schmich/g9impulse/assets/starcell_full.png

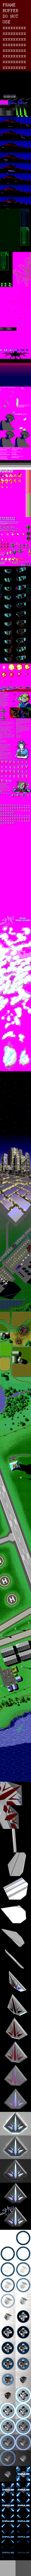
assets/starcell_full.png
