schmich/g9impulse/src/game/world.c

#include "world.h"
#include "updateable.h"
#include "projectile.h"
#include "player.h"
#include "input.h"
#include "enemy.h"
#include "awards.h"
#include "background.h"
#include "collision.h"
#include "level.h"
#include "artifact.h"
#include "health-meter.h"
#include "heat-meter.h"
#include "life-meter.h"
#include "nuke-meter.h"
#include "weapon-indicator.h"
#include "text.h"

#define SUICIDE_TIME 25

static bool suicide(void)
{
    static uint8 resetCounter = SUICIDE_TIME;
    Input* input = getInputStatus();

    if (input->buttonBPressed &&
        input->buttonAPressed &&
        input->selectPressed)
    {
        if (--resetCounter == 0)
            return true;
    }
    else
    {
        resetCounter = SUICIDE_TIME;
    }

    return false;
}

static void destroyWorld(World* w)
{
    Node* curr;

    foreach (curr, w->updateables)
        destroy(curr->data);

    foreach (curr, w->enemies)
        destroy(curr->data);

    foreach (curr, w->playerProjectiles)
        destroy(curr->data);

    foreach (curr, w->enemyProjectiles)
        destroy(curr->data);

    foreach (curr, w->overlays)
        destroy(curr->data);

    foreach (curr, w->underlays)
        destroy(curr->data);

    foreach (curr, w->artifacts)
        destroy(curr->data);

    destroy(w->updateables);
    destroy(w->enemies);
    destroy(w->playerProjectiles);
    destroy(w->enemyProjectiles);
    destroy(w->overlays);
    destroy(w->underlays);
    destroy(w->artifacts);

    destroy(w->lifeMeter);
    destroy(w->healthMeter);
    destroy(w->heatMeter);
    destroy(w->nukeMeter);
    destroy(w->weaponIndicator);

    destroy(w->awardsOverlay);

    destroy(w->player);
    destroyStatic(w->level);
}

World* createWorld(Player* player, Level* level)
{
    Point start;

    World* w = new(World);
    w->destroy = destroyWorld;

    w->updateables = createList();
    w->enemies = createList();
    w->playerProjectiles = createList();
    w->enemyProjectiles = createList();
    w->overlays = createList();
    w->underlays = createList();
    w->artifacts = createList();

    w->level = level;
    w->player = player;

    setSpriteCenterTop(player, screenCenterBottom());

    w->healthMeter = createHealthMeter(player, makePoint(130, 230));
    w->heatMeter = createHeatMeter(player, makePoint(1, 230));
    w->nukeMeter = createNukeMeter(player, makePoint(155, 3));
    w->lifeMeter = createLifeMeter(player, makePoint(154, 220));
    w->weaponIndicator = createWeaponIndicator(player, makePoint(1, 220));

    w->gameOver = false;
    w->awardsOverlay = NULL;

    w->respawnShow = true;
    w->respawning = false;
    w->respawnStep = 0;

#ifdef _DEBUG
    w->intro = false;
#else
    w->intro = true;
#endif

    w->introStep = 0;
    w->active = true;

    return w;
}

bool active(World* w)
{
    return w->active;
}

void addUpdateable(World* world, Updateable* u)
{
    appendElement(world->updateables, u);
}

void addEnemy(World* world, Enemy* e)
{
    ++world->player->stats->enemiesFaced;
    appendElement(world->enemies, e);
}

void addPlayerProjectile(World* world, Projectile* p)
{
    ++world->player->stats->shotsFired;
    appendElement(world->playerProjectiles, p);
}

void addEnemyProjectile(World* world, Projectile* p)
{
    ++world->player->stats->shotsFaced;
    appendElement(world->enemyProjectiles, p);
}

void addOverlay(World* world, Updateable* u)
{
    appendElement(world->overlays, u);
}

void addUnderlay(World* world, Updateable* u)
{
    appendElement(world->underlays, u);
}

void addArtifact(World* world, Artifact* a)
{
    ++world->player->stats->artifactsGiven;
    appendElement(world->artifacts, a);
}

Node* removeUpdateable(World* world, Node* u)
{
    destroy(u->data);
    return removeNode(world->updateables, u);
}

Node* removeEnemy(World* world, Node* e)
{
    destroy(e->data);
    return removeNode(world->enemies, e);
}

Node* removePlayerProjectile(World* world, Node* p)
{
    destroy(p->data);
    return removeNode(world->playerProjectiles, p);
}

Node* removeEnemyProjectile(World* world, Node* p)
{
    destroy(p->data);
    return removeNode(world->enemyProjectiles, p);
}

Node* removeOverlay(World* world, Node* u)
{
    destroy(u->data);
    return removeNode(world->overlays, u);
}

Node* removeUnderlay(World* world, Node* u)
{
    destroy(u->data);
    return removeNode(world->underlays, u);
}

Node* removeArtifact(World* world, Node* a)
{
    destroy(a->data);
    return removeNode(world->artifacts, a);
}

void drawWorld(World* world)
{
    uint8 i;
    Image* img;
    Node* curr;

    drawBackground(world->level->background);

    foreach (curr, world->underlays)
        drawSprite(curr->data);

    foreach (curr, world->artifacts)
        drawSprite(curr->data);

    foreach (curr, world->enemyProjectiles)
        drawSprite(curr->data);

    foreach (curr, world->enemies)
        drawSprite(curr->data);

    foreach (curr, world->playerProjectiles)
        drawSprite(curr->data);

    if (!dead(world->player) && world->respawnShow)
        drawPlayer(world->player);

    foreach (curr, world->updateables)
        drawSprite(curr->data);

    foreach (curr, world->overlays)
        drawSprite(curr->data);

    if (!world->gameOver)
    {
        drawSprite(world->heatMeter);
        drawSprite(world->healthMeter);
        drawNukeMeter(world->nukeMeter);
        drawLifeMeter(world->lifeMeter);
        drawWeaponIndicator(world->weaponIndicator);

        drawNumber(world->player->stats->score, makePoint(2, 2), COLOR_WHITE);

#ifdef _DEBUG
        drawNumber(world->level->background->progress, makePoint(2, 17), COLOR_WHITE);
        drawNumber(memoryFree(), makePoint(2, 31), COLOR_WHITE);
        drawNumber(world->player->stats->enemiesFaced, makePoint(2, 45), COLOR_WHITE);
#endif
    }
    else
    {
        drawAwardsOverlay(world->awardsOverlay);
    }
}

void updateWorld(World* world)
{
    Node* curr;
    int16 stop;

    if (world->intro)
    {
        update(world->player->engine, world); // HACK this sucks

        if (++world->introStep == 2)
        {
            stop = SCREEN_HEIGHT - (int16)spriteHeight(world->player) - 10;

            if (--world->player->position.y == stop)
                world->intro = false;

            world->introStep = 0;
        }
    }
    else
    {
        if (!dead(world->player))
            update(world->player, world);
    }

    if (world->respawning)
    {
        if (++world->respawnStep == 1)
        {
            world->respawnShow = !world->respawnShow;
            world->respawnStep = 0;

            if (++world->respawnCycles == 100)
                world->respawning = false;
        }
    }

    if (world->gameOver)
    {
        if (updateAwardsOverlay(world->awardsOverlay))
        {
            world->player->stats->score += totalBonus(world->awardsOverlay->awards);
            world->active = false;
        }
    }

    update(world->heatMeter, world);
    update(world->healthMeter, world);

    update(world->level->background, world);

    if (!world->gameOver)
        updateLevel(world->level, world);
    
    curr = world->updateables->head;
    while (curr != NULL)
    {
        if (update(curr->data, world) == UPDATE_REMOVE)
            curr = removeUpdateable(world, curr);
        else
            curr = curr->next;
    }

    curr = world->enemies->head;
    while (curr != NULL)
    {
        if (update(curr->data, world) == UPDATE_REMOVE)
            curr = removeEnemy(world, curr);
        else
            curr = curr->next;
    }

    curr = world->playerProjectiles->head;
    while (curr != NULL)
    {
        if (update(curr->data, world) == UPDATE_REMOVE)
            curr = removePlayerProjectile(world, curr);
        else
            curr = curr->next;
    }

    curr = world->enemyProjectiles->head;
    while (curr != NULL)
    {
        if (update(curr->data, world) == UPDATE_REMOVE)
            curr = removeEnemyProjectile(world, curr);
        else
            curr = curr->next;
    }

    curr = world->artifacts->head;
    while (curr != NULL)
    {
        if (update(curr->data, world) == UPDATE_REMOVE)
            curr = removeArtifact(world, curr);
        else
            curr = curr->next;
    }

    curr = world->overlays->head;
    while (curr != NULL)
    {
        if (update(curr->data, world) == UPDATE_REMOVE)
            curr = removeOverlay(world, curr);
        else
            curr = curr->next;
    }

    curr = world->underlays->head;
    while (curr != NULL)
    {
        if (update(curr->data, world) == UPDATE_REMOVE)
            curr = removeUnderlay(world, curr);
        else
            curr = curr->next;
    }
    
    if (!world->gameOver)
    {
        if (suicide())
        {
            kill(world->player, world);
        }

        if (dead(world->player))
        {
            if (empty(world->updateables))
            {
                if (world->player->lives == 0)
                {
                    world->gameOver = true;
                    world->awardsOverlay = createAwardsOverlay(world->player);
                }
                else
                {
                    respawnPlayer(world->player);

                    world->respawning = true;
                    world->respawnStep = 0;
                    world->respawnCycles = 0;
                    world->respawnShow = true;

                    world->intro = true;
                    world->introStep = 0;
                }
            }
        }
    }
}

void collideWorld(World* world)
{
    Node* proj;
    Node* enemy;
    Node* artifact;
    bool killed;
    
    //
    // collide enemies with player's projectiles
    //
    enemy = world->enemies->head;
    while (enemy != NULL)
    {
        killed = false;

        proj = collides(enemy->data, world->playerProjectiles);
        if (proj != NULL)
        {
            ++world->player->stats->shotsLanded;

            impact(proj->data, enemy->data, world);
            if (damage(enemy->data, ((Projectile*)proj->data)->damage))
            {
                killed = true;
                kill(enemy->data, world);
            }

            if (!((Projectile*)proj->data)->invincible)
                removePlayerProjectile(world, proj);
        }

        if (killed)
        {
            enemyKilled(world->player, enemy->data, false);
            enemy = removeEnemy(world, enemy);
        }
        else
            enemy = enemy->next;
    }

    if (!dead(world->player))
    {
        //
        // collide player with enemies' projectiles
        //
        proj = collides(world->player, world->enemyProjectiles);
        if (proj != NULL)
        {
            impact(proj->data, world->player, world);

#ifndef _DEBUG
            if (!world->respawning && damagePlayer(world->player, ((Projectile*)proj->data)->damage))
                kill(world->player, world);
#endif

            if (!((Projectile*)proj->data)->invincible)
                removeEnemyProjectile(world, proj);
        }

        //
        // collide player with artifacts
        //
        artifact = collides(world->player, world->artifacts);
        if (artifact != NULL)
        {
            affect(artifact->data, world->player, world);
            removeArtifact(world, artifact);
        }

        //
        // collide player with enemies themselves
        //
        enemy = collides(world->player, world->enemies);
        if (enemy != NULL)
        {
            if (!((Enemy*)enemy->data)->ground)
            {
#ifndef _DEBUG
                if (!world->respawning && damagePlayer(world->player, 2))
                    kill(world->player, world);
#endif

                enemyKilled(world->player, enemy->data, true);
                ++world->player->stats->kamikazes;

                if (damage(enemy->data, 50))
                {
                    kill(enemy->data, world);
                    removeEnemy(world, enemy);
                }
            }
        }
    }
}
