schmich/g9impulse/src/game/high-score.c

#include "text.h"
#include "input.h"
#include "storage.h"
#include "list.h"
#include "gpu.h"
#include "delay.h"
#include "background.h"
#include "score.anim.inl"
#include "high-score.h"

#define LOCATION_HIGH_SCORES 0
#define LOCATION_LAST_INITS  (LOCATION_HIGH_SCORES + (3 + 2) * 10)
#define LOCATION_MAGIC       1020

typedef struct ScoreEntry
{
    char   initials[4];
    uint16 score;
} ScoreEntry;

static void destroyScores(List* scores)
{
    Node* curr;

    foreach (curr, scores)
        free(curr->data);

    destroy(scores);
}

static bool validInitials(char* initials)
{
    char* c;
    for (c = initials; *c != NULL; ++c)
    {
        if (*c >= 'A' && *c <= 'Z')
            return true;

        if (*c >= '0' && *c <= '9')
            return true;

        if (*c == ' ')
            return true;
    }

    return false;
}

static bool validMagic(void)
{
    char magic[4];
    readStorage(magic, 4, LOCATION_MAGIC);

    return magic[0] == 0xDE
        && magic[1] == 0xAD
        && magic[2] == 0xBE
        && magic[3] == 0xEF;
}

static void saveHighScores(List* highScores)
{
    uint8 pos = LOCATION_HIGH_SCORES;

    Node* curr;
    ScoreEntry* entry;

    foreach (curr, highScores)
    {
        entry = (ScoreEntry*)curr->data;

        writeStorage(entry->initials, 3, pos);
        writeStorage((char*)&entry->score, 2, pos + 3);
        
        pos += 5;
    }
}

static List* loadHighScores(void)
{
    uint8 i;
    uint8 pos;
    List* scores = createList();
    ScoreEntry* entry;

    for (i = 0, pos = LOCATION_HIGH_SCORES; i < 10; ++i, pos += 5)
    {
        entry = new(ScoreEntry); 

        readStorage(entry->initials, 3, pos);
        entry->initials[3] = '\0';

        readStorage((char*)&entry->score, 2, pos + 3);

        appendElement(scores, entry);
    }

    return scores;
}

static bool displayHighScores(List* highScores, Node* scorePos)
{
    uint8 y;

    uint8 buffer;
    Animation* logo = logoAnimation();
    Animation* highScore = highScoreAnimation();

    char _[] = "_";
    uint8 pos = 0;
    char* initial;

    uint8 color;
    Node* curr;
    ScoreEntry* entry;
    Input* event = getInputEvent();

    //
    // HACK background repeat position hardcoded
    //
    Background* background = createBackground(6824);

    uint16 delay = 0;

    setDoubleBuffer(true);
    clearBuffers();
    while (!event->startPressed)
    {
        delay_ms(10);

        event = getInputEvent();
        if (scorePos != NULL)
        {
            initial = ((ScoreEntry*)scorePos->data)->initials + pos;

            if (event->buttonBPressed)
            {
                if (pos == 0)
                    pos = 2;
                else
                    --pos;
            }
            else if (event->buttonAPressed)
            {
                if (++pos > 2)
                    pos = 0;
            }
            else if (event->leftPressed)
            {
                if (*initial == 'A')
                    *initial = ' ';
                else if (*initial == ' ')
                    *initial = 'Z';
                else
                    --*initial;
            }
            else if (event->rightPressed)
            {
                if (*initial == 'Z')
                    *initial = ' ';
                else if (*initial == ' ')
                    *initial = 'A';
                else
                    ++*initial;
            }
        }
        else
        {
            delay += 10;
            if (delay >= 15000)
                return true;
        }

        drawBackground(background);
        drawImage(&logo->images[0], makePoint(0, 0), true);

        if (scorePos != NULL)
            drawImage(&highScore->images[0], makePoint(78, 15), true);

        update(background, NULL);

        y = 70;
        foreach (curr, highScores)
        {
            if (scorePos != curr)
                color = COLOR_WHITE;
            else
            {
                color = COLOR_BLUE;
                drawText(_, makePoint(85 + pos * textWidth(_), y - 1), COLOR_BLUE);
            }

            entry = (ScoreEntry*)curr->data;
            drawText(entry->initials, makePoint(85, y), color);
            drawNumber(entry->score, makePoint(115, y), color);

            y += 16;
        }

        flipBuffer(&buffer);
    }

    destroy(background);

    return false;
}

static void setDefaultHighScores(void)
{
    char magic[] = { 0xDE, 0xAD, 0xBE, 0xEF };
    char inits[] = "CPS_LH _ZC _JPC_EMS_SYB_ECE_ABC_XYZ_DEF";

    uint16 scores[] = {100, 99, 98, 97, 96,
                       95,  94, 93, 92, 91};

    uint8 i;
    char* currInit;
    List* highScores = createList();
    ScoreEntry* entry;

    for (i = 0; i < 10; ++i)
    {
        entry = new(ScoreEntry);

        entry->initials[0] = inits[i * 4];
        entry->initials[1] = inits[i * 4 + 1];
        entry->initials[2] = inits[i * 4 + 2];
        entry->initials[3] = '\0';
        entry->score = scores[i];

        appendElement(highScores, entry);
    }

    saveHighScores(highScores);
    writeStorage(inits, 3, LOCATION_LAST_INITS);
    writeStorage(magic, 4, LOCATION_MAGIC);

    destroyScores(highScores);
}

static Node* highScorePosition(uint16 score, List* highScores)
{
    Node* curr;
    ScoreEntry* entry;

    foreach (curr, highScores)
    {
        entry = (ScoreEntry*)curr->data;

        if (score > entry->score)
            return curr;
    }

    return NULL;
}

bool showHighScores()
{
    List* highScores;
    bool  startPressed;

    if (!validMagic())
        setDefaultHighScores();

    highScores = loadHighScores();
    startPressed = displayHighScores(highScores, NULL);

    destroyScores(highScores);
    return startPressed;
}

void checkHighScore(uint16 score)
{
    char initials[3];
    List* highScores;
    Node* scorePos;
    Node* newScore;
    ScoreEntry* entry;

    if (!validMagic())
        setDefaultHighScores();

    highScores = loadHighScores();

    scorePos = highScorePosition(score, highScores);
    if (scorePos != NULL)
    {
        entry = new(ScoreEntry);
        entry->score = score;

        readStorage(entry->initials, 3, LOCATION_LAST_INITS);
        entry->initials[3] = '\0';

        if (!validInitials(entry->initials))
        {
            //
            // somehow we got into an inconsistent state with the
            // last initials entered, so just reset them
            //
            entry->initials[0] = entry->initials[1] = entry->initials[2] = 'A';
        }

        newScore = insertElement(highScores, scorePos, entry);
        removeNode(highScores, highScores->tail);

        displayHighScores(highScores, newScore);
        saveHighScores(highScores);

        writeStorage(entry->initials, 3, LOCATION_LAST_INITS);
    }

    destroyScores(highScores);
}
