schmich/g9impulse/src/game/enemy.c

#include "enemy.h"

static void destroyEnemy(Enemy* e)
{
    destroy(e->behavior);
}

static void fireEnemy(Entity* e, World* w)
{
    e->spawnProjectile(e, w, spriteCenterBottom(e));
}

Enemy* createEnemy(Animation* anim,
                   uint8 initFrame, 
                   Behavior* behavior,
                   uint16 health,
                   Point where,
                   SpawnFn onProjectileSpawn,
                   KillFn onKill)
{
    Enemy* e = new(Enemy);
    e->destroy = destroyEnemy;
    e->behavior = behavior;
    e->position = where;
    e->health = e->maxHealth = health;
    e->kill = onKill;
    e->fire = fireEnemy;
    e->animation = anim;
    e->currentFrame = initFrame;
    e->spawnProjectile = onProjectileSpawn;
    e->ground = false;

    return e;
}
