schmich/g9impulse/src/game/entity.c

#include "entity.h"

void kill(Entity* who, World* world)
{
    damage(who, who->health);
    who->kill(who, world);
}

bool damage(Entity* who, uint16 damage)
{
    if (damage >= who->health)
    {
        who->health = 0;
        return true;
    }
    else
    {
        who->health -= damage;
        return false;
    }
}

bool dead(Entity* who)
{
    return who->health == 0;
}

void fire(Entity* e, World* w)
{
    e->fire(e, w);
}

void nullFire(Entity* e, World* w)
{
    // do nothing!
}

void nullProjectileSpawn(Entity* e, World* w, Projectile** p)
{
    *p = NULL;
}
