schmich/g9impulse/src/game/world.h

#ifndef WORLD_H
#define WORLD_H

#include "common.h"
#include "destroyable.h"
#include "list.h"

typedef struct Player Player;
typedef struct Background Background;
typedef struct Updateable Updateable;
typedef struct Projectile Projectile;
typedef struct Artifact Artifact;
typedef struct Enemy Enemy;
typedef struct Level Level;
typedef struct HealthMeter HealthMeter;
typedef struct HeatMeter HeatMeter;
typedef struct NukeMeter NukeMeter;
typedef struct LifeMeter LifeMeter;
typedef struct WeaponIndicator WeaponIndicator;
typedef struct AwardsOverlay AwardsOverlay;

typedef struct World
{
    DESTROYABLE_BASE;

    bool    active;

    List*   updateables;
    List*   enemies;
    List*   playerProjectiles;
    List*   enemyProjectiles;
    List*   overlays;
    List*   underlays;
    List*   artifacts;

    Player* player;
    Level*  level;

    HealthMeter*        healthMeter;
    HeatMeter*          heatMeter;
    NukeMeter*          nukeMeter;
    LifeMeter*          lifeMeter;
    WeaponIndicator*    weaponIndicator;

    AwardsOverlay* awardsOverlay;

    bool    respawnShow;
    bool    respawning;
    uint8   respawnStep;
    uint8   respawnCycles;

    bool    intro;
    uint8   introStep;

    bool    gameOver;
} World;

World* createWorld(Player* player, Level* level);

bool active(World* world);

void drawWorld(World* world);
void updateWorld(World* world);
void collideWorld(World* world);

void addUpdateable(World* world, Updateable* u);
void addPlayerProjectile(World* world, Projectile* p);
void addEnemyProjectile(World* world, Projectile* p);
void addEnemy(World* world, Enemy* e);
void addOverlay(World* world, Updateable* u);
void addUnderlay(World* world, Updateable* u);
void addArtifact(World* world, Artifact* a);

Node* removeUpdateable(World* world, Node* u);
Node* removePlayerProjectile(World* world, Node* p);
Node* removeEnemyProjectile(World* world, Node* p);
Node* removeEnemy(World* world, Node* e);
Node* removeOverlay(World* world, Node* u);
Node* removeUnderlay(World* world, Node* u);
Node* removeArtifact(World* world, Node* a);

#endif // WORLD_H
