schmich/g9impulse/src/game/projectile.c

#include "projectile.h"

static void destroyProjectile(Projectile* p)
{
    destroy(p->behavior);
}

Projectile* createProjectile(Animation* anim,
                             uint8 initFrame,
                             Behavior* behavior,
                             uint8 damage,
                             Point where,
                             ImpactFn onImpact,
                             bool invincible)
{
    Projectile* p = new(Projectile);
    p->destroy = destroyProjectile;
    p->behavior = behavior;
    p->position = where;
    p->damage = damage;
    p->impact = onImpact;
    p->animation = anim;
    p->currentFrame = initFrame;
    p->invincible = invincible;

    return p;
}

void impact(Projectile* proj, Sprite* who, World* world)
{
    proj->impact(proj, who, world); 
}

void nullImpact(Projectile* proj, Sprite* who, World* world)
{
    // do nothing!
}
