schmich/g9impulse/src/game/projectile.h

#ifndef PROJECTILE_H
#define PROJECTILE_H

#include "common.h"
#include "updateable.h"

struct Projectile;
typedef near rom void (*ImpactFn)(struct Projectile*, Sprite*, World*);

#define PROJECTILE_BASE UPDATEABLE_BASE; \
                        uint8 damage; \
                        ImpactFn impact; \
                        bool invincible

typedef struct Projectile
{
    PROJECTILE_BASE;
} Projectile;

Projectile* createProjectile(Animation* anim,
                             uint8 initFrame,
                             Behavior* behavior,
                             uint8 damage,
                             Point where,
                             ImpactFn onImpact,
                             bool invincible);

void impact(Projectile* proj, Sprite* who, World* world);
void nullImpact(Projectile*, Sprite*, World*);

#endif // PROJECTILE_H
