schmich/g9impulse/(commit log)

2006-02-05 Initial checkin of StarCell project files.
    [I2C.obj, gpu_pic.obj, gpuchip_pad.csv, midi.obj, vga-timing.xls]
2006-02-05 Removed a bunch of cruft.
    [I2C.obj, gpu_pic.obj, midi.obj]
2006-02-05 cleaned up repository. added up to date art.
    [gpuchip_pad.csv]
2006-02-13 currently not working (not sure why). Committing to check out old version
    [intro.c, iomain.c, main.c]
2006-02-19 deleted old directories that we never used
    [vga-timing.xls]
2006-02-26 Added collision detection, enemy shooting, improved behaviors, levels, spawning. Added cloud and plasma entities. Integrated explosions and enemy deaths. Fixed input system.
    [animation.h, background.c, background.h, cloud.c, cloud.h, collision.c]
2006-02-27 Fixed glitching (for XSA-50) remember to propogate these changes to the XSA-100
    [gpuchip.vhd]
2006-02-27 Added medium and large explosion data, much improved Makefile, player death now resets game, added beginnings of artifacts.
    [artifact.c, artifact.h, destroyable.c, destroyable.h, explosion.c, level.h, main.c]
2006-03-03 Added fractional movements to Boring behavior (doesn't work that well), added player health sprite in screen corner.
    [cloud.c, cloud.h, intro.c]
2006-03-04 Infrastructure rework because of realization: projectiles, enemies, etc, should be completely specified at runtime, i.e. no special structures/data for any of them.
    [enemy.c, enemy.h, player.c]
2006-03-04 Temporarily broken, renamed Sprite to Figure.
    [enemy.c, figure.c, figure.h, intro.c, player.c, player.h, sprite.c]
2006-03-04 Temporarily broken, renamed Entity to Sprite.
    [cloud.c, collision.c, enemy.c, entity.c, entity.h]
2006-03-04 Fixed player/enemy shooting, moved some files to sdk/
    [enemy.c, enemy.h, entity.c, entity.h, main.c, player.c]
2006-03-05 Added Paste syntax highlighting and indentation scripts for vim. Added prototype level script (still refining syntax).
2006-03-09 Added Bresenham line-following behavior, work-independent framerate, made background drawing opaque.
2006-03-09 Added pausing functionality, chopper enemy, MiG enemy, background looping (in space), first powerup (health), blinking health meter, functional heat meter, player scroll-in introduction.
2006-03-09 Added animations for chopper, powerups, MiG, pausing, and heat meter.
2006-03-12 Many EOH changes: Added level looping Implemented heat meter Added ground tanks Made powerups smaller Added player engine rendering Added fonts and text drawing Added missle seek (for MiG) Added new 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
2006-03-21 added schematic and board layout
    [top_level.sch]
2006-03-23 Final schematic before beginning of board design (I hope)
    [top_level.sch]
2006-04-02 GLEU now using VS.NET-style interface, functionality currently broken.
2006-04-02 started work on board
    [top_level.sch]
2006-04-07 Last commit before sending Peter the schematic for quote
2006-04-07 deleted abortive effort at board
2006-04-08 Reverted back to pre-broken schematic
    [top_level.sch]
2006-04-10 Changed font sizes (new font), worked on parser, but currently breaks under C++ compilation.
2006-04-13 PCB as turned in by James. Slight error by J6 easily correctable and silkscreen changes.
    [top_level.sch]
2006-04-14 added final(hopefully) gerbers for Rev X1
2006-04-16 Major progress on Paste Lexing/parsing works in C++ Most of enemy lexing complete Building enemy/definition tree in parser Groundwork laid for remaining bits of parser
2006-04-18 stupid conflict
    [top_level.brd]
2006-04-21 fixed font again! working arcade input
    [blitter.vhd, gpuchip.vhd, iomain.c]
2006-04-22 Added EEPROM read/write functions. Modified animations to not use spaces. Updated parser to handle new fields (currently broken, though).
    [enemy.h, intro.c, player.c, player.h]
2006-04-25 Moved starcell_full.png to production/. Moved soft reset handling to main.c. Updated high score handling to save last initials entered. Removed bomb.png. Updated TODO.
    [high-score.c, main.c, world.c]
2006-04-25 Modified pause text graphic. Fixed high score screen memory leak. Memory leak still exists somewhere during gameplay :(
    [high-score.c, main.c]
2006-04-27 Updated engine animation. Updated PAUSE graphic. Improved engine logic. Fixed setDoubleBuffer() bug.
    [engine.c, engine.h, high-score.c, intro.c, main.c, player.c]
2006-05-03 Added blue text. Implemented beam weapon. Added ship enemy. Added new explosion. Updated powerup graphics. Added nuke powerup.
2006-05-03 Added camera batteries to MUSTDO.
2006-05-04 Fixed pause graphic invisibility bug.
    [main.c]
2006-05-04 Fixed post-pause flicker bug.
    [main.c]
2006-05-04 Added weapon switching (weapon paths). Added weapon indicator panel.
2006-05-08 more level, fixed the build problem. Green lasers.
    [awards.c]
2006-05-14 Fixed crazy-stupid spawning memory bug. Fixed storage-writing bug. Made high score resetting more robust.
    [high-score.c]
2006-05-14 added gpu bitcode for flash on board program with this to have design be more robust
2006-05-14 Implemented 2 stages of boss behavior. Added "boost" section of map. Added to level.
